Wiktor1288/Line-follower-EAGLE/trasa.jpg

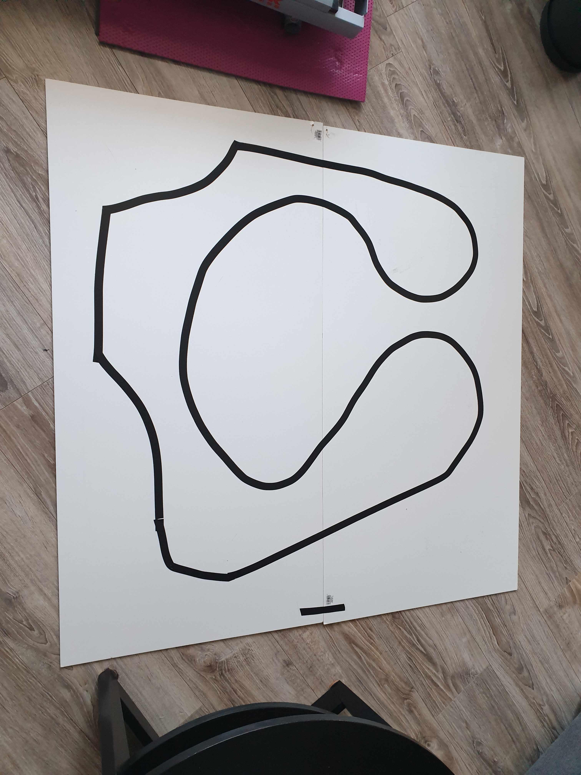
trasa.jpg
