Wiktor1288/Line-follower-EAGLE/20210602_003822.jpg

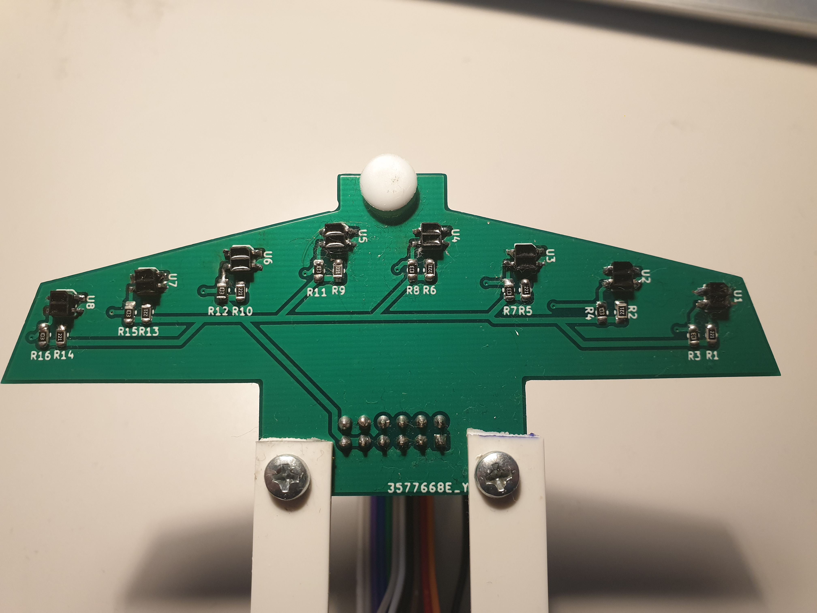
20210602_003822.jpg
