Wiktor1288/Line-follower-EAGLE/PlytkaGlowna/PlytkaGlowna.kicad_pcb

## KiCad design PlytkaGlowna/PlytkaGlowna.kicad_pcb (2021-05-13)

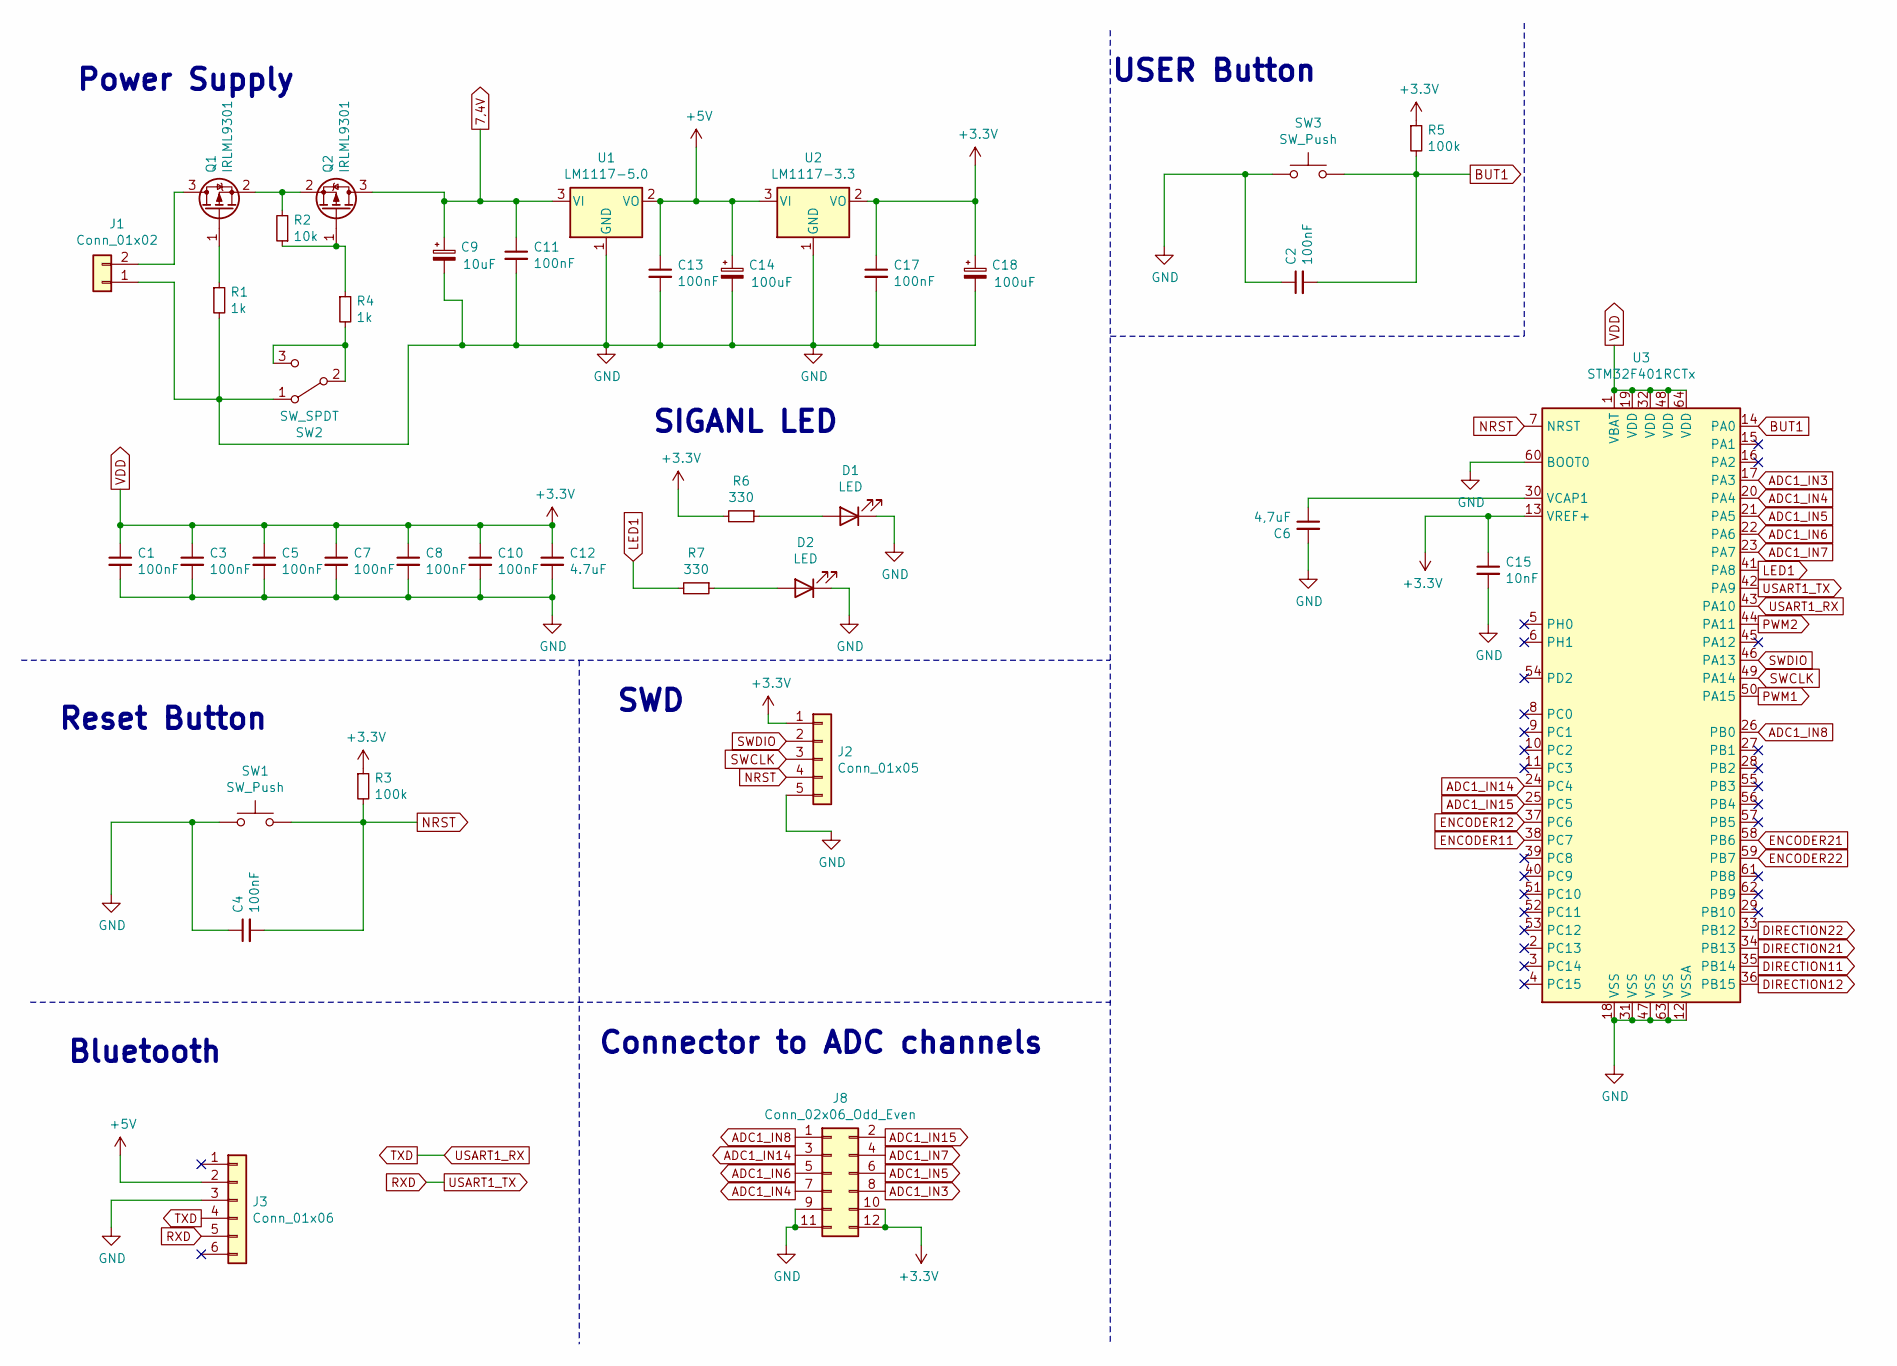
[picture p4: schematic STM32.sch]

Parts:
C1, C2, C3, C4, C5, C7, C8, C10, C11, C13: 100nF; C_0805_2012Metric_Pad1.18x1.45mm_HandSolder
C6: 4,7uF; C_0603_1608Metric_Pad1.08x0.95mm_HandSolder
C9: 10uF; CP_Elec_4x5.4
C12: 4.7uF; C_0603_1608Metric_Pad1.08x0.95mm_HandSolder
C14, C18: 100uF; CP_Elec_6.3x5.4
C15: 10nF; C_0805_2012Metric_Pad1.18x1.45mm_HandSolder
C17: 100nF; C_0603_1608Metric_Pad1.08x0.95mm_HandSolder
D1, D2: LED; LED_D5.0mm
J1: Conn_01x02; JST_EH_B2B-EH-A_1x02_P2.50mm_Vertical
J2: Conn_01x05; PinSocket_1x05_P2.54mm_Vertical
J3: Conn_01x06; PinSocket_1x06_P2.54mm_Vertical
J8: Conn_02x06_Odd_Even; PinHeader_2x06_P2.54mm_Vertical
Q1, Q2: IRLML9301; SOT-23
R1, R4: 1k; R_0805_2012Metric_Pad1.20x1.40mm_HandSolder
R2: 10k; R_0805_2012Metric_Pad1.20x1.40mm_HandSolder
R3, R5: 100k; R_0805_2012Metric_Pad1.20x1.40mm_HandSolder
R6, R7: 330; R_0805_2012Metric_Pad1.20x1.40mm_HandSolder
SW1, SW3: SW_Push; TactSwitchSMD
SW2: SW_SPDT; Przelacznik
U1: LM1117-5.0; SOT-223-3_TabPin2
U2: LM1117-3.3; SOT-223-3_TabPin2
U3: STM32F401RCTx; LQFP-64_10x10mm_P0.5mm

Connections:
7,4V: C9.1, C11.1, Q2.3 (D), U1.3 (VI); also elsewhere on the board
+5V: C13.1, C14.1, J3.2, U1.2 (VO), U2.3 (VI); also elsewhere on the board
ADC1_IN3: J8.8, U3.17 (PA3)
ADC1_IN4: J8.7, U3.20 (PA4)
ADC1_IN5: J8.6, U3.21 (PA5)
ADC1_IN6: J8.5, U3.22 (PA6)
ADC1_IN7: J8.4, U3.23 (PA7)
ADC1_IN8: J8.1, U3.26 (PB0)
ADC1_IN14: J8.3, U3.24 (PC4)
ADC1_IN15: J8.2, U3.25 (PC5)
AIN1: U3.35 (PB14); also elsewhere on the board
AIN2: U3.36 (PB15); also elsewhere on the board
BIN1: U3.34 (PB13); also elsewhere on the board
BIN2: U3.33 (PB12); also elsewhere on the board
BUT1: C2.2, R5.2, SW3.2, U3.14 (PA0)
ENCODER11: U3.38 (PC7); also elsewhere on the board
ENCODER12: U3.37 (PC6); also elsewhere on the board
ENCODER21: U3.58 (PB6); also elsewhere on the board
ENCODER22: U3.59 (PB7); also elsewhere on the board
GND: C1.2, C2.1, C3.2, C4.1, C5.2, C6.2, C7.2, C8.2, C9.2, C10.2, C11.2, C12.2, C13.2, C14.2, C15.2, C17.2, C18.2, D1.1 (K), D2.1 (K), J1.1, J2.5, J3.3, J8.9, J8.11, R1.2, SW1.1, SW2.1 (A), SW3.1, U1.1 (GND), U2.1 (GND), U3.12 (VSSA), U3.18 (VSS), U3.31 (VSS), U3.47 (VSS), U3.60 (BOOT0), U3.63 (VSS); also elsewhere on the board
LED1: R7.2, U3.41 (PA8)
NRST: C4.2, J2.4, R3.2, SW1.2, U3.7 (NRST)
unnamed: C6.1, U3.30 (VCAP1)
unnamed: D1.2 (A), R6.1
unnamed: D2.2 (A), R7.1
unnamed: J1.2, Q1.3 (D)
unnamed: Q1.1 (G), R1.1
unnamed: Q1.2 (S), Q2.2 (S), R2.2
unnamed: Q2.1 (G), R2.1, R4.1
unnamed: R4.2, SW2.2 (B), SW2.3 (C)
PWM1: U3.50 (PA15); also elsewhere on the board
PWM2: U3.44 (PA11); also elsewhere on the board
RXD: J3.5, U3.42 (PA9)
SWCLK: J2.3, U3.49 (PA14)
SWDIO: J2.2, U3.46 (PA13)
TXD: J3.4, U3.43 (PA10)
VDD: C1.1, C3.1, C5.1, C7.1, C8.1, C10.1, C12.1, C15.1, C17.1, C18.1, J2.1, J8.10, J8.12, R3.1, R5.1, R6.2, U2.2 (VO), U3.1 (VBAT), U3.13 (VREF+), U3.19 (VDD), U3.32 (VDD), U3.48 (VDD), U3.64 (VDD); also elsewhere on the board

Notes on the sheet:
Power Supply
Reset Button
SWD
Connector to ADC channels
Bluetooth
USER Button
SIGANL LED

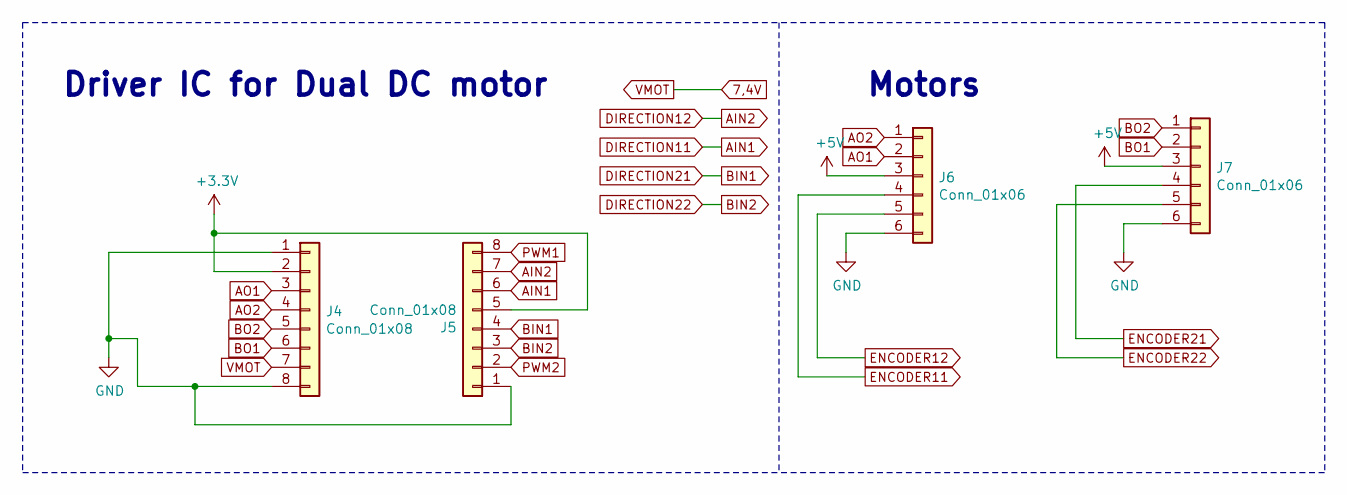
[picture p5: schematic Motors.sch]

Parts:
J4, J5: Conn_01x08; PinSocket_1x08_P2.54mm_Vertical
J6, J7: Conn_01x06; PinSocket_1x06_P2.54mm_Vertical

Connections:
7,4V: J4.7; also elsewhere on the board
+5V: J6.3, J7.3; also elsewhere on the board
AIN1: J5.6; also elsewhere on the board
AIN2: J5.7; also elsewhere on the board
AO1: J4.3, J6.2
AO2: J4.4, J6.1
BIN1: J5.4; also elsewhere on the board
BIN2: J5.3; also elsewhere on the board
BO1: J4.6, J7.2
BO2: J4.5, J7.1
ENCODER11: J6.4; also elsewhere on the board
ENCODER12: J6.5; also elsewhere on the board
ENCODER21: J7.4; also elsewhere on the board
ENCODER22: J7.5; also elsewhere on the board
GND: J4.1, J4.8, J5.1, J6.6, J7.6; also elsewhere on the board
PWM1: J5.8; also elsewhere on the board
PWM2: J5.2; also elsewhere on the board
VDD: J4.2, J5.5; also elsewhere on the board

Notes on the sheet:
Driver IC for Dual DC motor
Motors

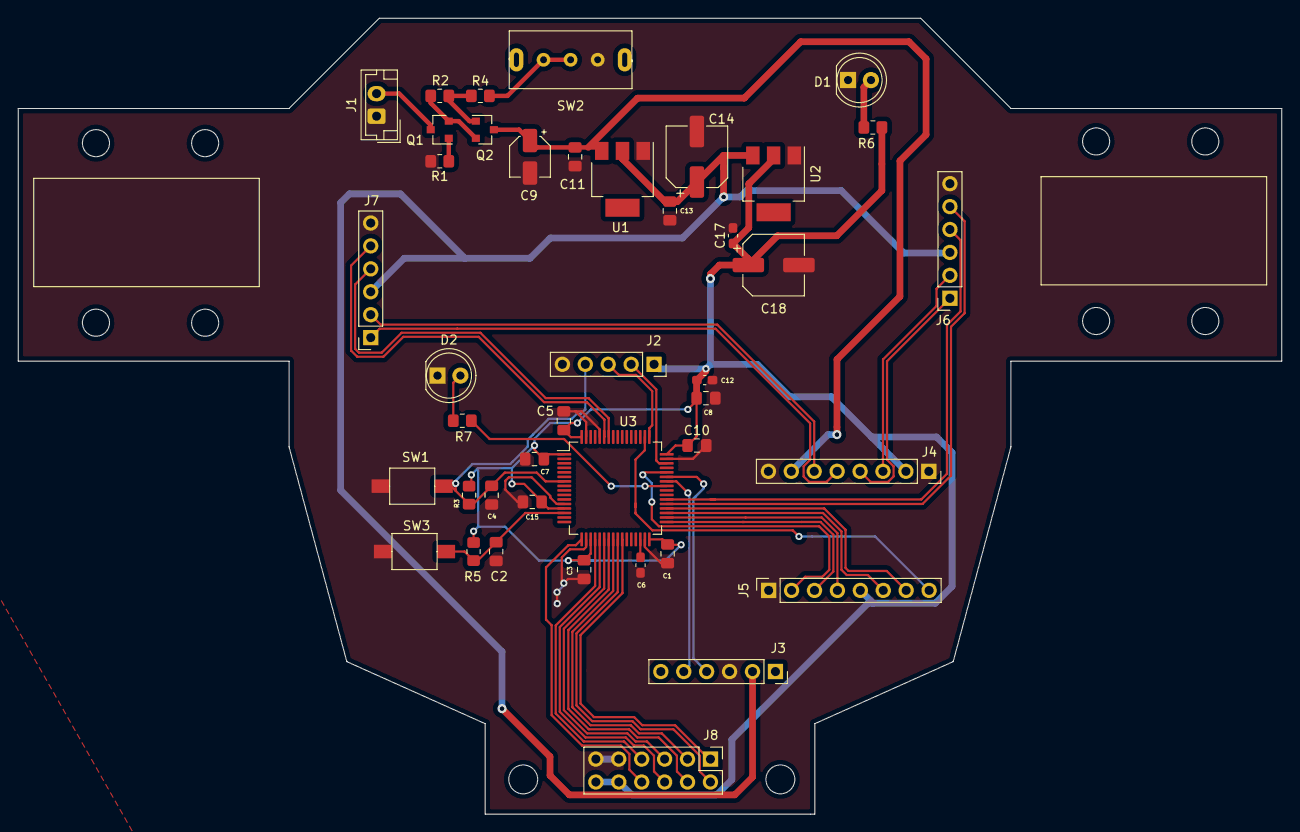
[picture p6: board PlytkaGlowna.kicad_pcb from above]

Board: 2 copper layers, 140.0 x 88.2 mm, 42 parts (0 on the bottom side), 41 nets.
