Wiktor1288/Line-follower-EAGLE/CzujnikOdb/CzujnikOdb.kicad_pcb

## KiCad design CzujnikOdb/CzujnikOdb.kicad_pcb (2021-05-13)

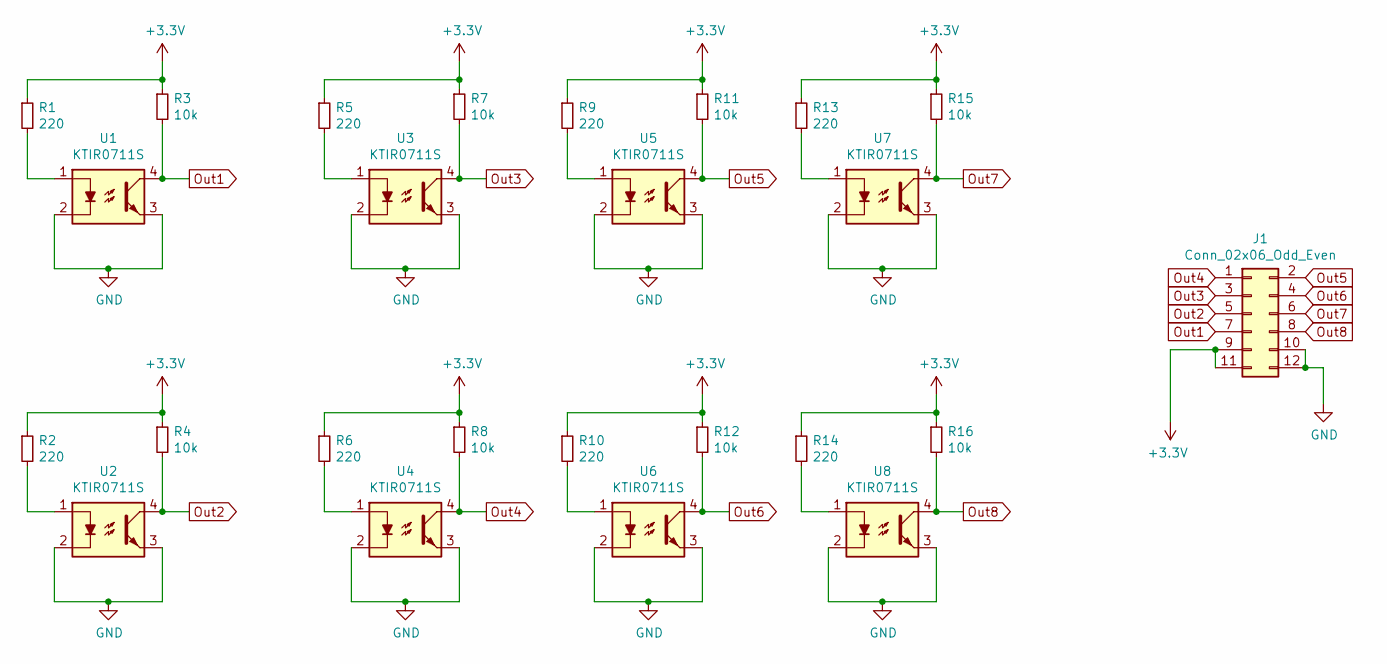
[picture p7: schematic CzujnikOdb.sch]

Parts:
J1: Conn_02x06_Odd_Even; PinHeader_2x06_P2.54mm_Vertical
R1, R2, R5, R6, R9, R10, R13, R14: 220; R_0805_2012Metric_Pad1.20x1.40mm_HandSolder
R3, R4, R7, R8, R11, R12, R15, R16: 10k; R_0805_2012Metric_Pad1.20x1.40mm_HandSolder
U1, U2, U3, U4, U5, U6, U7, U8: KTIR0711S

Connections:
+3V3: J1.9, J1.11, R1.1, R2.1, R3.1, R4.1, R5.1, R6.1, R7.1, R8.1, R9.1, R10.1, R11.1, R12.1, R13.1, R14.1, R15.1, R16.1
GND: J1.10, J1.12, U1.2, U1.3, U2.2, U2.3, U3.2, U3.3, U4.2, U4.3, U5.2, U5.3, U6.2, U6.3, U7.2, U7.3, U8.2, U8.3
unnamed: R1.2, U1.1
unnamed: R2.2, U2.1
unnamed: R5.2, U3.1
unnamed: R6.2, U4.1
unnamed: R9.2, U5.1
unnamed: R10.2, U6.1
unnamed: R13.2, U7.1
unnamed: R14.2, U8.1
Out1: J1.7, R3.2, U1.4
Out2: J1.5, R4.2, U2.4
Out3: J1.3, R7.2, U3.4
Out4: J1.1, R8.2, U4.4
Out5: J1.2, R11.2, U5.4
Out6: J1.4, R12.2, U6.4
Out7: J1.6, R15.2, U7.4
Out8: J1.8, R16.2, U8.4

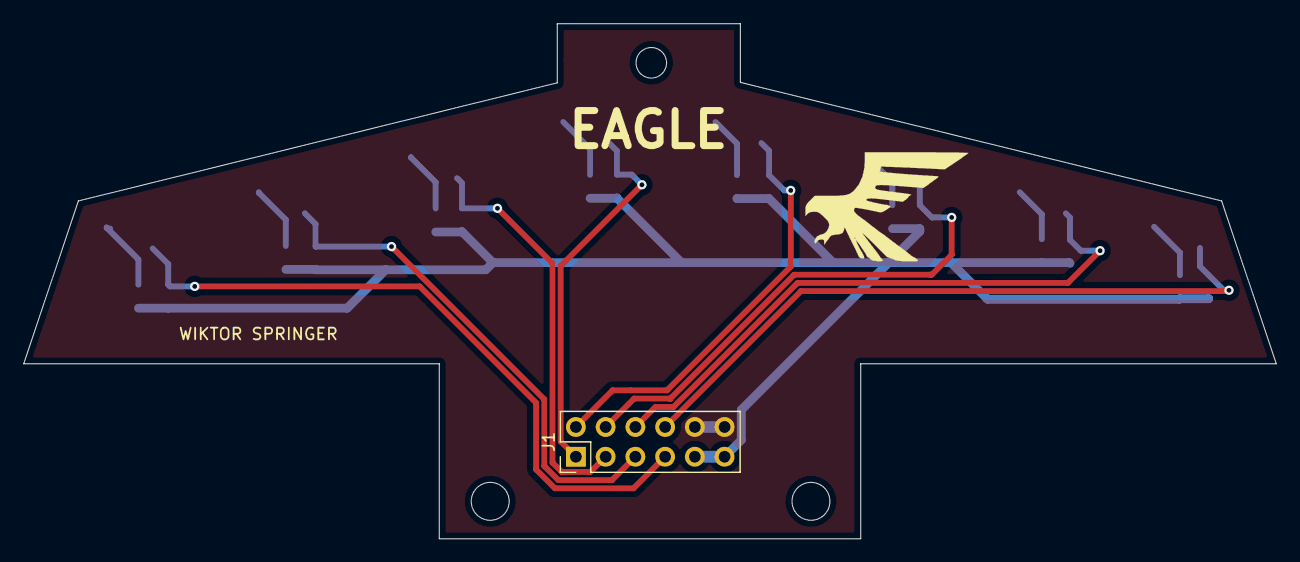
[picture p8: board CzujnikOdb.kicad_pcb from above]

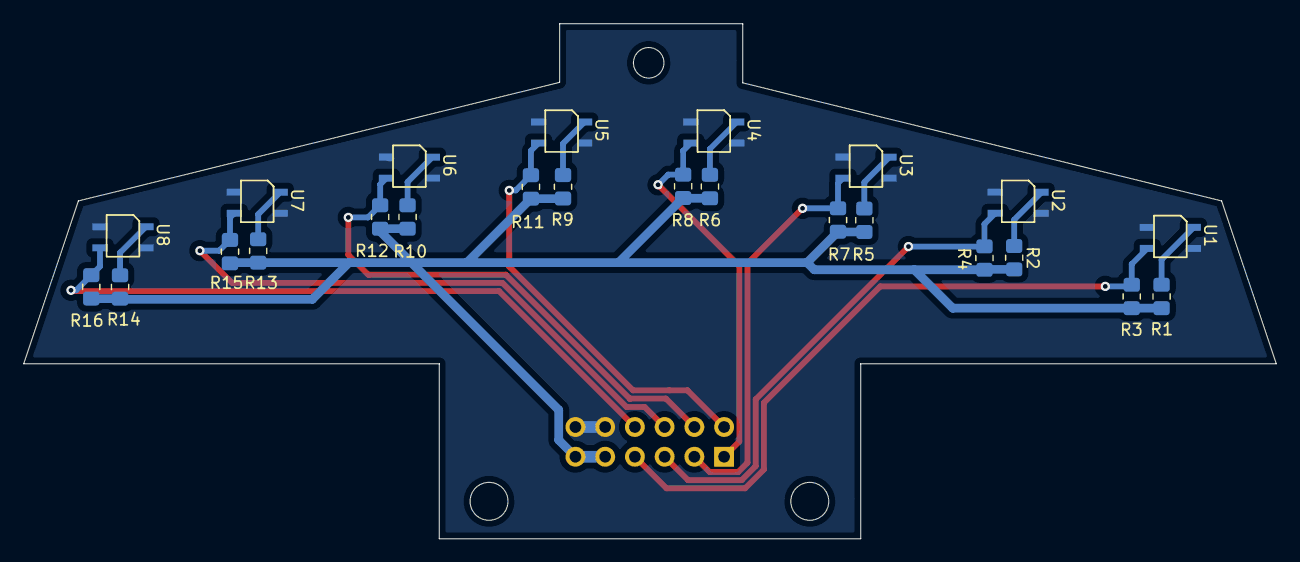
[picture p9: board CzujnikOdb.kicad_pcb from below]

Board: 2 copper layers, 107.0 x 44.0 mm, 25 parts (24 on the bottom side), 18 nets.
