Wiktor1288/Line-follower-EAGLE/STM32 Program/algline/algline.ioc

Mcu.UserName=STM32F401RCTx
PA0-WKUP.GPIO_Label=BUT1
PA0-WKUP.Signal=GPXTI0
PA10.Signal=USART1_RX
PA11.Signal=S_TIM1_CH4
PA13.Signal=SYS_JTMS-SWDIO
PA14.Signal=SYS_JTCK-SWCLK
PA15.Signal=S_TIM2_CH1_ETR
PA3.Signal=ADCx_IN3
PA4.Signal=ADCx_IN4
PA5.Signal=ADCx_IN5
PA6.Signal=ADCx_IN6
PA7.Signal=ADCx_IN7
PA8.GPIO_Label=LED1
PA8.Signal=GPIO_Output
PA9.Signal=USART1_TX
PB0.Signal=ADCx_IN8
PB12.GPIO_Label=D22
PB12.Signal=GPIO_Output
PB13.GPIO_Label=D21
PB13.Signal=GPIO_Output
PB14.GPIO_Label=D11
PB14.Signal=GPIO_Output
PB15.GPIO_Label=D12
PB15.Signal=GPIO_Output
PC4.Signal=ADCx_IN14
PC5.Signal=ADCx_IN15
