Wiktor1288/Line-follower-EAGLE/STM32 Program/algline/Core/Inc/main.h

#define BUT1_Pin GPIO_PIN_0
#define BUT1_GPIO_Port GPIOA
#define BUT1_EXTI_IRQn EXTI0_IRQn
#define D22_Pin GPIO_PIN_12
#define D22_GPIO_Port GPIOB
#define D21_Pin GPIO_PIN_13
#define D21_GPIO_Port GPIOB
#define D11_Pin GPIO_PIN_14
#define D11_GPIO_Port GPIOB
#define D12_Pin GPIO_PIN_15
#define D12_GPIO_Port GPIOB
#define LED1_Pin GPIO_PIN_8
#define LED1_GPIO_Port GPIOA
