Wiktor1288/Line-follower-EAGLE/(commit log)

2021-05-02 Dodanie schematu i projekt PCB przod
    [CzujnikOdb.kicad_pcb, CzujnikOdb.sch]
2021-05-05 plytka glowna
    Dodanie projektu PCB plytki glownej
    [CzujnikOdb.kicad_pcb, Motors.sch, PlytkaGlowna.kicad_pcb, PlytkaGlowna.sch, STM32.sch]
2021-05-10 next version of PCBs
    Next version of PCBs
    [CzujnikOdb.kicad_pcb, Motors.sch, PlytkaGlowna.kicad_pcb, STM32.sch]
2021-05-11 final version 1
    i hope
    [PlytkaGlowna.kicad_pcb, STM32.sch]
2021-05-13 Final version v2
    [CzujnikOdb-B_Cu.gbr, CzujnikOdb-B_Mask.gbr, CzujnikOdb-B_Paste.gbr, CzujnikOdb-B_SilkS.gbr, CzujnikOdb-Edge_Cuts.gbr, CzujnikOdb-F_Cu.gbr, CzujnikOdb-F_Mask.gbr, CzujnikOdb-F_Paste.gbr]
