Wiktor1288/Line-follower-EAGLE/20210602_003634.jpg

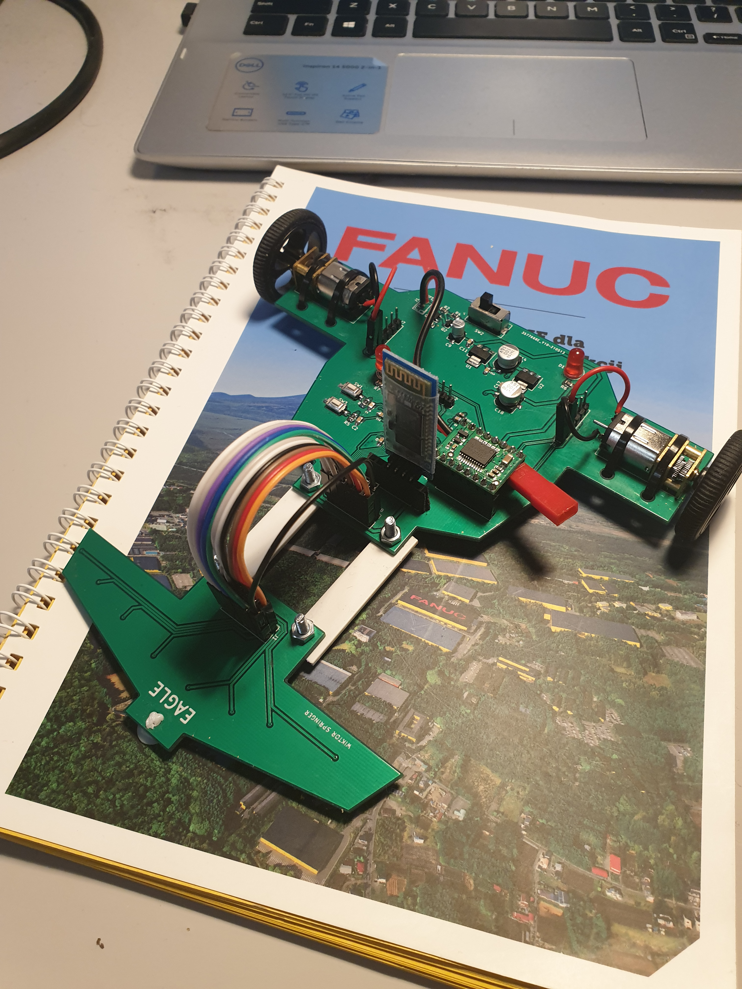
20210602_003634.jpg
